Willianlsz1/piezometro-teste/(commit log)

2026-03-28 feat: melhorias completas para defesa do TCC
2026-07-09 Revisão do projeto: firmware versionado, limiares unificados e correções de segurança
    - Adiciona firmware/sketch.ino: código Wokwi com envio ao InfluxDB via WiFi
    (line protocol, a cada 10s), buzzer não bloqueante, loop com millis() e
    notas sobre a limitação do BMP180 como stand-in do transdutor piezométrico
    - Adiciona firmware/diagram.json: circuito Wokwi completo (ESP32 + BMP180 +
    OLED SSD1306 + 3 LEDs + buzzer)
    - Unifica limiares de alerta em 1010/1005 hPa (firmware, dashboard e README),
    compatíveis com o padrão do BMP180 no Wokwi (1013,25 hPa)
    - Dashboard: banner inequívoco de modo simulação + eventos marcados
    '(simulação)'; mín/máx/variação calculados sobre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
    [sketch.ino]
2026-07-09 Reformula projeto para a demanda SAGA: nível d'água, alertas Telegram/SMS e ingestão via servidor
    Alinhamento com o desafio 'Monitoramento Online do Nível de Água em
    Piezômetros' (Samarco / SENAI Mariana):
    - Telemetria passa a ser nível d'água (m): firmware converte a pressão do
    BMP180 (stand-in) em nível simulado (10 hPa = 1 m) e a lógica de alerta
    vira a correta de piezômetro — nível ALTO = perigo (12 m atenção, 15 m
    crítico), espelhada em firmware, dashboard e servidor
    - Alertas preventivos ativos: server.js vigia o InfluxDB e notifica por
    Telegram (gratuito) e/ou SMS via Twilio nas transições de faixa, com
    anti-spam e reenvio do crítico a cada 15 min; hist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
    [sketch.ino]
2026-07-09 Adiciona mapeamento demanda SAGA × projeto × mercado real
    Documento de pesquisa que decompõe a demanda em 8 requisitos e cruza cada
    um com a prática de mercado (Geokon/corda vibrante, Worldsensing/LoRa,
    CMI da Samarco em Germano), a regulação (Res. ANM 95/2022, Lei 14.066/2020,
    níveis de emergência do PAEBM, SIGBM) e projetos acadêmicos similares —
    com fontes citadas e roadmap priorizado de melhorias de autenticidade
    (múltiplos piezômetros, carta de risco, transdutor 4-20mA + ADS1115,
    solar + deep sleep, LoRa no hardware real).
    Claude-Session: https://claude.ai/code/session_018LetC9Cjgkx1fkLP5TURfU
2026-07-09 Adiciona pacote do protótipo físico com sensor JSN-SR04T
    - firmware/sketch_fisico_jsn_sr04t.ino: versão para hardware real que mede
    nível de água de verdade com ultrassônico JSN-SR04T (mediana de 5 leituras,
    zona morta tratada, mantém último nível válido em falha de eco), com a
    mesma pilha do firmware de simulação: WiFi, NTP, store & forward e envio
    JSON ao /ingest com DEVICE_KEY — mesmos limiares 12/15 m via escala de
    maquete (1 cm no tubo = 0,5 m)
    - docs/PROTOTIPO_FISICO.md: lista de compras (~R$ 150-220) com links,
    esquema de ligação pino a pino (divisor de tensão 1k/2k no ECHO),
    montagem do tubo, calibração, roteiro de demonstração de 3 min para a
    ban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
2026-07-09 Adiciona arquitetura alternativa sem servidor (placa e dashboard direto no InfluxDB)
    - firmware/sketch_sem_servidor.ino: variante Wokwi em que o ESP32 grava
    direto no InfluxDB Cloud (line protocol, store & forward com timestamps
    NTP) e dispara os alertas do Telegram direto do firmware, com o mesmo
    anti-spam do servidor (transições de faixa + reenvio do crítico a cada
    15 min); URL do cluster e org já pré-preenchidos, trade-offs documentados
    - index.html: novo bloco INFLUX_DIRECT — preenchendo um token somente
    leitura, o dashboard consulta o InfluxDB Cloud direto do navegador e
    dispensa o Render; barra de status indica o modo ativo (direto/via
    servidor)
    - readme.md: seçã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
2026-07-10 Servidor monitora múltiplos piezômetros e corrige referências quebradas
    - /ingest aceita o campo 'piezometro' (validado) e grava como tag do line
    protocol; leituras sem id continuam funcionando (compatibilidade)
    - Motor de alertas por instrumento: consulta agrupada por tag (parser CSV
    suporta múltiplas tabelas de grupo), estado de notificação por id e
    mensagens do Telegram/SMS identificando qual piezômetro disparou
    - GET /alerts expõe o último estado conhecido de cada piezômetro
    - Corrige referências sem definição no handler HTTP herdadas do merge
    feat/tcc-melhorias-completas (checkRateLimit/log/metrics/url/ip), que
    derrubavam o servidor em qualquer requisição; rate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
2026-07-10 Dashboard multi-piezômetro: visão geral, mapa, períodos, CSV, leituras e guia do operador
    - Visão geral com cartão clicável por piezômetro (PZ-01/02/03) e painel de
    localização com mapa Leaflet/OpenStreetMap (pinos coloridos pelo status,
    fallback gracioso sem CDN); dados agrupados pela tag 'piezometro'
    - Seletor de período 24h/7d/30d nos históricos, com estatísticas e rótulos
    dinâmicos por janela
    - Exportação CSV compatível com Excel pt-BR (BOM, ';', vírgula decimal)
    do piezômetro e período selecionados
    - Painel 'Últimas leituras' (hora, nível, status) e eventos identificados
    por instrumento
    - Faixa recolhível 'Como ler este painel' e descrições curtas nos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
2026-07-10 Migra consultas de Flux para InfluxQL (compatível com InfluxDB Cloud Serverless)
    Contas novas do InfluxDB Cloud são Serverless e não respondem ao endpoint
    Flux (/api/v2/query) — as consultas voltavam vazias mesmo com dados no
    bucket (a escrita v2 funciona). Migração da camada de leitura para o
    endpoint v1 (/query) com InfluxQL, compatível com contas TSM e Serverless:
    - index.html: influxQL() consulta o v1 /query (modo direto com token de
    leitura, ou via novo proxy /queryql); fetchLatest/fetchHistory reescritos
    em InfluxQL com parsing JSON (parseCSV removido); contratos de retorno
    preservados (gráficos, CSV, tabela e visão geral intactos)
    - server.js: motor de alertas consult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
2026-07-10 Remove arquitetura antiga (Render + InfluxDB direto) substituida pelo Cloudflare Worker
    - server.js, test.js, package.json, .env.example: o backend agora e o
    Worker em cloudflare-worker/ (D1 + KV), sem servidor Node no Render
    - firmware/sketch_sem_servidor.ino: a variante que escrevia direto no
    InfluxDB deixa de existir junto com o InfluxDB
2026-07-10 Migra backend para Cloudflare Worker + D1 (v2 da arquitetura)
    - cloudflare-worker/: Worker com /ingest, /ultimos, /dados, /alerts e
    /health; leituras no D1 (SQLite), motor de alertas Telegram/SMS via
    cron trigger de 1 min com estado no KV (gravacao condicional)
    - index.html: dashboard consome /ultimos e /dados (JSON) em vez de
    InfluxQL via proxy; removidos PROXY_URL e INFLUX_DIRECT
    - firmware: comentarios e SERVER_URL de exemplo apontam para o Worker
    - readme.md: reescrito para a nova arquitetura, com secao de historico
    registrando a v1 (Render + InfluxDB)
    - sketch.ino da raiz removido (versao antiga que escrevia direto no
    InfluxDB com token embutido)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
2026-07-10 Adiciona base de conhecimento: piezometros, barragens e mercados de aplicacao
    Documento-fonte consolidado a partir de pesquisa (fontes citadas por secao):
    fisica da poropressao (Terzaghi), tipos de piezometro, instalacao/leitura,
    niveis de controle, desastres de Fundao e Brumadinho, legislacao (PNSB,
    Lei 14.066, ANM 95/2022 e 220/2025), numeros do setor e mercados adjacentes
    com ranking para o pitch. Base para o TCC, slides e video pitch.
2026-07-10 Corrige agregacao por bucket no /dados e configura deploy real
    - CAST(ts / bucket AS INTEGER): o D1 fazia divisao em ponto flutuante,
    o que anulava o agrupamento por bucket (verificado em producao)
    - wrangler.toml: database_id real do D1
    - index.html: API_URL apontando para o Worker publicado
2026-07-10 Adiciona CLAUDE.md com contexto do projeto e modelo de trabalho 10-80-10
2026-07-10 Refatoracao de arquitetura: seams profundos nas tres camadas
    Candidato 1 - Fonte de Leituras (index.html): interface unica
    {simulada, ultimos(), historico()} com dois adapters (FonteApi e
    FonteSimulada). Elimina a simulacao duplicada/desalinhada (bases 10.2
    vs 10), o setInterval paralelo do simTick e o vazamento do flag
    simActive; troca real<->simulacao concentrada em trocarFonte().
    Candidato 2 - Nucleo comum do firmware: piezometro_core.h (411 l.)
    com WiFi/NTP/buffer/envio/alertas/LEDs/buzzer/OLED; sketches viram
    adapters de sensor (555->141 e 652->224 linhas). struct Leitura no
    core (e a interface, nao detalhe do sketch). Sensor da Fase 2 entra
    como 3o adapter.
    Candidato 3 - GET /config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
    [piezometro_core.h, sketch.ino, sketch_fisico_jsn_sr04t.ino]
2026-07-10 Adiciona pesquisa sobre dashboards profissionais e plano de melhorias
    Plataformas comerciais (MonitorIQ, GeoMoS, Worldsensing, VDV), tratamento
    de perda de sinal (Good/Uncertain/Bad, stale data), estados de instrumento,
    leituras derivadas (taxa de variacao, % projeto), normas ISA-101/ISA-18.2/
    EEMUA 191 e anti-padroes - com plano priorizado P1-P8 para o dashboard.
2026-07-10 P1+P2+P3: estado SEM SINAL, alarme de comunicacao e taxa de variacao
    P1 (dashboard): instrumento sem reportar alem de STALE_SEG vira estado
    SEM SINAL (cinza hachurado, cor+texto, "ultima leitura ha X min");
    alarme de nivel suspenso com dado stale (ausente nunca conta como
    normal); gap visivel no grafico sem interpolar; leitura velha nao e
    re-registrada como nova; marcador cinza no mapa.
    P2 (worker): camada de alarme de comunicacao separada da de nivel -
    silencio > SILENCE_ALERT_SEC notifica Telegram/SMS na transicao (e na
    recuperacao), estado commStatus no KV; alertLog ganha campo tipo
    (nivel/comunicacao/taxa). Verificado em producao (PZ-01 SEM_SINAL).
    P3 (worker+dashboard): taxa de variac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
2026-07-10 P4+P5+P6: alarmes vs eventos, pico junto da media e sobriedade ISA-101
    P4: painel dividido em ALARMES (exigem acao - com a acao esperada por
    linha) e EVENTOS (informativos), listas separadas com contadores;
    histerese assimetrica (subida imediata, descida exige folga de
    HISTERESE_M=0.2 abaixo do limiar) no worker (classifyComHisterese no
    motor) e no dashboard (badge e deteccao de borda) - elimina alarme
    chattering na borda do limiar (ISA-18.2 deadband).
    P5: /dados agrega MAX(nivel_agua) por bucket alem da media; grafico
    de nivel desenha a serie do pico como linha tracejada com legenda;
    stat MAX 24H usa o pico; CSV ganha coluna nivel_max. Validado com
    dados reais: bucket com media 13,84 m (AT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
2026-07-10 Adiciona plano de refatoracao anti-godfile (dashboard e worker em modulos)
2026-07-10 Refatora worker em 7 modulos ES (config, http, db, alertas, notificacoes, rotas, index)
    Zero mudanca de comportamento - validado em producao com a bateria completa de endpoints. index.js virou so o roteador (~76 l.); db.js e dono de todas as queries D1 (query de /ultimos unificada com a da camada de comunicacao na revisao).
2026-07-10 Refatora dashboard: index.html (277 l.) + styles.css + 8 modulos JS
    Zero mudanca de comportamento - CSS em assets/styles.css e o script em assets/js/{config,util,fontes,estado,graficos,paineis,exportar,app}.js carregados em ordem de dependencia (escopo global, sem bundler - compativel com GitHub Pages). Validado no navegador: render identico, console limpo.
2026-07-10 Atualiza guia da maquete para a arquitetura v2 e adiciona roteiro de defesa
    PROTOTIPO_FISICO.md: referencias Render/InfluxDB trocadas por Cloudflare Worker (SERVER_URL, DEVICE_KEY via wrangler secret). DEFESA_BANCA.md: posicionamento frente a equipamentos profissionais, com perguntas provaveis e respostas.
2026-07-13 Corrige falso 'sem sinal' no dashboard com Wokwi em simulacao
    Frescor/comunicacao passam a usar a hora de RECEBIMENTO no Worker
    (nova coluna recebido_em) em vez do ts do device, que deriva no
    relogio simulado do Wokwi. Firmware re-sincroniza NTP a cada 5 min
    e STALE_SEG sobe de 60 para 120s (simulacao roda mais lenta que o
    tempo real). Migracao: migrations/0001_recebido_em.sql (aplicar
    antes do wrangler deploy).
    Claude-Session: https://claude.ai/code/session_01RKkR7Ama1X95U16pZjmgTV
    [piezometro_core.h]
2026-07-13 Adiciona deploy automatico do Worker via GitHub Actions
    Workflow que aplica a migracao do D1 (idempotente) e publica o Worker
    a cada push na main que toque cloudflare-worker/, ou manualmente pela
    aba Actions. Pensado para operar o projeto so pelo navegador, sem
    terminal. Requer o secret CLOUDFLARE_API_TOKEN no repositorio.
    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
2026-07-13 Integridade do monitoramento + docs de validacao e defesa da banca
    Worker: /ingest falha fechado sem DEVICE_KEY; indice unico
    (piezometro, ts) + INSERT OR IGNORE torna o reenvio do buffer
    idempotente (migracao 0002); ts ausente reconstruido pela posicao
    no lote; piezometro invalido e rejeitado em vez de virar PZ-01.
    Firmware: falha de OLED/BMP180 degrada em vez de travar (while(1)
    removido); wifiOk atualizado a cada despacho; leitura sem eco nao
    e enviada como medicao nova (campo valida no struct Leitura).
    Dashboard: token de requisicao elimina race na troca de pz/periodo;
    poll imediato ao voltar de aba em background; CSV exporta o periodo
    completo (histPontos), nao a janela de 60 pontos do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
2026-07-13 Workflow de deploy aplica tambem a migracao 0002 (dedupe + indice unico)
    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
2026-07-13 Adiciona rascunho do TCC estruturado no template oficial do SENAI
    docs/TCC_RASCUNHO.md espelha as secoes do TEMPLATE_INTEGRA_MG.docx
    (Problema, Solucao, Justificativa, Objetivos, Desenvolvimento,
    Viabilidades, Resultados, Anexos/BMG Canvas), preenchido com o
    conteudo ja documentado do projeto e marcadores [PREENCHER] onde
    dependem da equipe (nomes, resultados do ensaio de validacao,
    situacao de aprendizagem).
    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
2026-07-13 Adiciona viabilidade economica detalhada e comparativo de mercado pesquisado
    VIABILIDADE_ECONOMICA.md: BOM nos cenarios prototipo (R$150-220) e
    campo real (R$586-1.179), OPEX, tres metodos de precificacao
    convergindo em R$1.000-3.500/ponto + assinatura R$30-80/mes,
    paybacks do cliente (<46 dias), TAM/SAM/SOM com premissas editaveis
    e a separacao demanda SAGA vs mercado comercial real.
    COMPARATIVO_MERCADO.md: pesquisa web (17 buscas, 13/07/2026) — 8
    fabricantes de telemetria geotecnica sem preco publico, unica
    referencia dura US$1.636-2.370/instrumento (IBRACON 2007),
    plataformas IoT genericas e projetos academicos proximos, com
    fontes e avisos do que nao pode ser verificado.
    Co-Authored-B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
2026-07-13 Adiciona cenario hipotetico da reducao dos R$600 mil/ano (secao 4.3)
    Decompoe o numero do edital em contrato terceirizado plausivel
    (R$50 mil/mes, ~100 pz lidos 2x/semana ≈ R$58/leitura), mostra
    item a item o que o sistema elimina e o que permanece, e calcula a
    reducao: custo recorrente cai de R$600 mil para R$50-62 mil/ano
    (~90%), payback da implantacao em 2-4 meses.
    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
2026-07-13 CSV de auditoria no export + doc da cadeia de confianca
    Export CSV: bloco de metadados (instrumento, periodo, intervalo de
    agregacao, gerado em, fonte real/simulada, limiares, total de
    intervalos), colunas de minimo e nº de leituras por intervalo,
    status calculado pelo PICO (P5 — pico de 17 m nao sai mais como
    Normal pela media) e coluna de qualidade (nivel zero suspeito,
    poucas leituras). Worker /dados devolve nivel_min, n_leituras e
    bucket_seg; historico() passa a devolver { pontos, bucket_seg }
    nos dois adapters.
    Novo docs/CADEIA_DE_CONFIANCA.md: integridade vs validade
    metrologica, tabela elo→protecao→codigo, quem garante no mundo
    real (RBC/projetista/ANM) e lacunas admitidas.
    Co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
2026-07-13 Exportar Excel formatado no modelo de relatorio (SpreadsheetML)
    Novo botao 'Exportar Excel' gera planilha .xls sem biblioteca
    externa: titulo mesclado, linhas de contexto/auditoria, cabecalho
    colorido, celula de Status na cor da faixa (pelo pico) e secao
    RESUMO DO PERIODO (min/max/media e contagem de intervalos em
    atencao/critico) — organizacao espelhada na planilha-modelo do
    usuario. CSV mantido como dados brutos; ambos partem das mesmas
    linhas via coletarLinhasExportacao() (regra unica, P5).
    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
2026-07-13 Adiciona doc de alimentacao de energia (hoje, mercado, dimensionamento)
    Consumo atual ~30 Wh/dia (WiFi sempre ligado); o que o mercado usa
    (baterias de litio de anos nos nos wireless; 12V+solar nas
    estacoes); tres opcoes dimensionadas com conta aberta: powerbank
    (2 dias), solar 20W + bateria 18Ah (3,6 dias sem sol, sem mudar
    codigo) e deep sleep (~30x menos consumo, trade-offs honestos);
    recomendacao em camadas e resposta pronta para a banca (lacuna
    ANM 95/2022).
    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
2026-07-14 Implementa modo deep sleep opcional para campo a bateria/solar
    Novo firmware/piezometro_deep_sleep.h (opt-in via MODO_DEEP_SLEEP):
    ciclo acorda-mede-envia-dorme de 5 min com buffer de store &
    forward em memoria RTC (96 leituras, ~2,3 KB — sobrevive ao sono),
    payload byte-compativel com o do core, re-sync de NTP pela
    validade do relogio (que persiste no RTC) ou a cada ~1 h, e tela
    rapida de depuracao no OLED. Modo padrao dos sketches permanece
    sempre-ligado (demonstracao da maquete). Docs de energia e
    CLAUDE.md atualizados.
    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
2026-07-14 Reescreve o rascunho do TCC em prosa profissional (primeira entrega)
    Texto corrido humanizado, sem travessoes nem listas de hifen,
    incorporando todo o material produzido: cadeia de confianca do
    dado, exportacao de relatorios, modo deep sleep, energia
    dimensionada, comparativo de mercado com fontes, cenario dos
    R$600 mil, precificacao por tres metodos e TAM/SAM/SOM. Tabelas
    apenas onde o template exige (equipe e BMG Canvas); 8 marcadores
    [PREENCHER] consolidados ao final.
    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
2026-07-14 Gera TCC_ENTREGA.docx nas normas ABNT para envio ao professor
    Documento Word real gerado do rascunho: capa, folha de rosto e
    sumario; A4 com margens 3/3/2/2 cm; Arial 12 justificado,
    espacamento 1,5 e recuo de 1,25 cm; titulos na numeracao do
    template SENAI; tabelas de equipe e BMG Canvas; marcadores
    [PREENCHER] em vermelho/negrito para nao passarem despercebidos.
    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
2026-07-14 TCC autocontido: remove referencias a arquivos do repositorio e cita automacao
    O texto nao manda mais o leitor 'ver docs/*.md' — o conteudo
    referenciado (componentes, protocolo de validacao, demonstracao de
    resiliencia, base do BMG Canvas) foi escrito no proprio TCC. A
    Situacao de Aprendizagem passa a citar automacao de processos
    entre as competencias. TCC_ENTREGA.docx regenerado e validado.
    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
2026-07-14 Viabilidade economica assertiva: numeros fechados, payback e ROI
    Secao 1.3.6 reescrita com convicção: produto custa R$220
    (prototipo), R$900 (campo) e R$1.400 instalado; empresa gasta
    R$600 mil/ano e passa a gastar R$57 mil/ano; economia de R$543
    mil/ano (91%), payback de 3,1 meses, ROI de 288% no primeiro ano
    e >1.800% em cinco anos; preco de R$2.500/ponto + R$50/mes com
    payback do cliente em ~6 meses. Removidos TAM/SAM/SOM, faixas
    repetidas e a cifra de centenas de milhoes; mercado em duas
    frases concretas (1% = 900 pontos = R$540 mil/ano recorrentes).
    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
2026-07-14 Profissionalizacao: chave por dispositivo, retencao de dados e blueprint
    Worker: DEVICE_KEYS (JSON pz→chave) permite revogacao individual
    sem afetar a frota, com fail-closed mantido e checagem fina de
    qual pz cada chave autoriza; retencao automatica consolida
    leituras brutas com mais de 180 dias em 1 linha/dia/pz
    (leituras_diario, migracao 0003) e roda 1x/dia pelo cron com
    guarda no KV — erro na retencao nao derruba o salvamento do
    estado dos alertas (try/catch adicionado na revisao).
    Novo docs/PROJETO_PROFISSIONAL.md: especificacao da versao de
    producao construida sobre a plataforma existente (sensor via
    adapter, energia deep sleep+solar, LoRaWAN, seguranca, dados,
    operacao, conformidad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
2026-07-14 TCC posiciona o prototipo como representacao e o trabalho como o conjunto
    Tres insercoes: em Solucao, o papel de cada parte (prototipo =
    representacao funcional; produto do trabalho = plataforma +
    especificacao profissional + pesquisa + economia + validacao);
    em Desenvolvimento, a versao de producao (adapter, deep sleep,
    LoRaWAN, chave por dispositivo e retencao ja implementadas,
    roadmap com custos); em Resultados, o conjunto de engenharia que
    existe independentemente do prototipo. Docx regenerado.
    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
2026-07-14 Separa docs em projeto/ (face empresa) e prototipo/ (maquete/banca)
    - docs/projeto/: base de conhecimento, mercado, padroes ISA e a nova
    especificacao industrial PROJETO_INDUSTRIAL.md (AquaSense/UCT), com
    secao 10 consolidando as divergencias abertas com o rascunho do TCC
    (shunt 250 vs 150 ohms, MQTT/Grafana vs backend Cloudflare, IP66/67,
    numeros economicos)
    - docs/prototipo/: guia da maquete fisica, defesa na banca e plano de
    refatoracao executado
    - Corrige todos os links para os novos caminhos (readme, CLAUDE.md,
    wrangler.toml, firmware e comentarios do codigo)
    [sketch_fisico_jsn_sr04t.ino]
2026-07-14 Reescreve viabilidade economica para o sistema industrial (UCT AquaSense)
    BOM com precos reais pesquisados (16 buscas, fontes e datas),
    fechamento exato dos R$260 mil em 50 pontos (hardware 148.250 +
    instalacao 40.000 + sobressalentes 14.825 + bancada 25.000 +
    contingencia 31.925), OPEX anual real de R$39.155 (chips M2M,
    nuvem, manutencao, inspecoes), payback 5,6 meses, ROI 116% ano 1
    e 978% em 5 anos, com analise de sensibilidade. Prototipo fora do
    escopo (apenas representacao).
    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
2026-07-14 OPEX: registra as duas rotas de reducao do custo dos chips 4G
    Plano IoT sob medida (R$5-10/mes, item cai a R$6 mil/ano) e
    gateway LoRaWAN compartilhado (1 chip de backhaul, R$240/ano).
    R$12 mil/ano mantido na conta principal como pior caso com fonte.
    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
2026-07-14 Fecha as 7 divergencias TCC x repositorio e alinha IP66 (pendencia 2)
    Secao 10 do PROJETO_INDUSTRIAL vira registro de decisoes fechadas:
    shunt 150 ohms, backend real Cloudflare, IP66 nos dois textos
    (RNF2/diagramas/BOM alinhados de IP67 para IP66), Telegram/SMS,
    par economico oficial (R$260 mil / payback 5,6 meses / -93,5%),
    cadencia de demonstracao explicitada e WiFi só no prototipo.
    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
2026-07-14 Pendencia 3: TCC oficial AquaSense no repositorio; rascunho vira historico
    TCC_AQUASENSE.md transcreve fielmente o TCC da equipe (PDF) com as
    correcoes fechadas: titulo sem placeholder, composicao oficial dos
    R$260 mil, OPEX/reducao de 93,5%/payback/ROI na viabilidade,
    grafia piezorresistivo/ESP32, BOM com custo de referencia e
    marcadores [PREENCHER] nos anexos pendentes. TCC_ENTREGA.docx
    regenerado (ABNT) a partir dele. TCC_RASCUNHO.md recebe nota de
    documento historico/material-fonte.
    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
2026-07-14 Pendencia 4: protocolo de homologacao da UCT na bancada de 2 m
    Fisica do ensaio com contas abertas (3,2 mA/m; 4,0-10,4 mA e
    0,6-1,56 V na bancada; resolucao do ADS1115), cinco etapas (loop
    eletrico, calibracao de dois pontos, curva de exatidao 5x10,
    resistencia de 72 h com cortes provocados de rede e energia,
    ensaio de energia) e criterios go/no-go (exatidao +-3 cm,
    repetibilidade 2 sigma <= 2 cm, zero perda/duplicata, deriva RTC
    < 2 s/dia) com tabelas prontas e frase de aceite final.
    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
2026-07-14 Pendencia 5: adapter da UCT industrial (transdutor 4-20 mA + ADS1115)
    Novo sketch_uct_4a20ma.ino pelo contrato de adapter do core:
    ADS1115 com GAIN_ONE (0,6-3,0 V do shunt de 150 ohms), media de 16
    amostras, calibracao de dois pontos como defines (coeficientes da
    etapa E2 da homologacao), deteccao de falha NAMUR NE43 (<3,6 mA
    loop rompido, >21 mA curto — leitura invalida nao entra no
    historico), modo degradado sem while(1), display com corrente e
    tensao do loop, compatibilidade com sempre-ligado e deep sleep, e
    roteiro de teste de bancada no rodape. CLAUDE.md e
    PROJETO_INDUSTRIAL.md anotados.
    Claude-Session: https://claude.ai/code/ses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
2026-07-14 Pendencia 6: fonte/powerbank opcional na lista de compras da maquete
    Item opcional recomendado (R$30-80): independencia do notebook na
    apresentacao e demonstracao ao vivo da opcao A do estudo de
    energia. Total obrigatorio de R$150-220 preservado (numero citado
    no TCC), com anotacao do adicional.
    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
2026-07-14 Reescreve a viabilidade economica do TCC em linguagem acessivel
    Secao 1.3.6 reestruturada apos pesquisa de metodologia (SEBRAE/
    EVTE): cada custo com a historia de como foi levantado (pesquisa
    de precos em lojas nacionais com exemplos, hora tecnica, piso de
    R$1.804 vs referencia R$2.965 explicada), reconstrucao dos
    R$600 mil contada passo a passo (R$50 mil/mes -> R$58/leitura),
    payback e ROI traduzidos em palavras (cada R$1 vira R$2,16 no
    ano 1 e quase R$11 em 5 anos), pesquisa de mercado narrada e
    jargao eliminado. Numeros oficiais preservados. Docx regenerado.
    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
2026-07-14 Adiciona secao REFERENCIAS ao TCC (47 fontes em formato ABNT)
    Compila todas as fontes que sustentam o documento: legislacao
    (PNSB, Lei 14.066, Resolucao ANM 95/2022), dados oficiais ANA/
    SNISB, normas tecnicas (ISA-18.2, NAMUR NE43), os oito fabricantes
    da pesquisa de mercado, o artigo IBRACON 2007, as lojas da
    pesquisa de precos com data de acesso e o edital SAGA. Ordem
    alfabetica, NBR 6023; referencias renderizadas no docx sem recuo
    e com espacamento simples (padrao ABNT). Sumario atualizado.
    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
2026-07-14 Graficos na viabilidade economica e tabelas no padrao ABNT aberto
    Tres graficos gerados em Python (paleta azul/laranja validada por
    contraste e daltonismo, imprime bem em P&B): composicao do
    investimento (barras horizontais), custo anual manual x AquaSense
    (reducao de 93,5% visivel) e saldo acumulado com ponto de
    equilibrio em 5,6 meses. Embutidos no docx com legenda ABNT acima
    e fonte abaixo; PNGs versionados em docs/tcc/graficos. Todas as
    tabelas convertidas de grade completa para tabela aberta ABNT
    (linhas horizontais no topo, cabecalho e base).
    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
2026-07-15 Demo fisica HC-SR04 no repo + diario de bordo do bring-up
    - firmware/sketch_demo_hc_sr04.ino: adapter da demo de bancada sem agua
    (mao = agua; 10 cm = critico), credenciais sanitizadas, compilado e
    gravado com sucesso no ESP32 fisico (82% da flash)
    - docs/prototipo/BRINGUP_FISICO.md: estado real da montagem (driver
    CP210x resolvido, upload via botao BOOT, store & forward confirmado)
    e pendencias com diagnostico (sensor sem eco: 4 causas; OLED; WiFi)
    - readme: arvore atualizada com firmware e docs que faltavam
2026-07-15 Alinha o TCC ao escopo real e gera a entrega no template INTEGRA
    Escopo (o texto declarava como feito trabalho fisico inexistente):
    - Fase III dizia que a equipe conectou o transdutor a bancada e calibrou
    o shunt de 150 ohms por dois pontos; isso nao aconteceu e contradizia
    a propria secao de Resultados. Reescrita para o que houve: o
    desenvolvimento do backend e a definicao do metodo de calibracao.
    - Fase II dizia que Marcelo montou o circuito fotovoltaico e Matheus
    montou a tubulacao de PVC; ambos sao projeto/dimensionamento da
    unidade industrial, nao montagem. Corrigido.
    - Fase IV e Resultados passam a registrar o que existe de fato: o
    prototipo funcional de bancada (microcontr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
2026-07-15 Protege o gerador contra a marcacao de titulo removida por engano
    Ao preencher o codigo da unidade e facil apagar tambem o "# " inicial,
    que e a marcacao de titulo do markdown e nao parte do placeholder. Sem
    ela o parser nao encontrava nenhum heading de nivel 1 e o script morria
    com IndexError, sem dizer o motivo.
    Agora o gerador valida a primeira linha e, se ela nao comecar com "# ",
    explica o formato esperado. O titulo passa a ser o primeiro heading de
    nivel 1 (em vez de ser procurado pelo texto do placeholder), e o script
    avisa quando o codigo da unidade ainda nao foi preenchido ou nao esta
    entre cerquilhas como o manual exige.
    Preenchido: instrutor orientador (Jairo).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
2026-07-15 Corrige o titulo da capa, que nunca era substituido, e fecha os campos
    Bug: a capa saia com o texto "TÍTULO DO PROJETO" do template em vez do
    titulo do trabalho. O Word quebra o texto em varios <w:r>/<w:t>
    ("TÍTULO DO " + "PROJETO"), entao procurar o marcador run a run nunca
    casava e a substituicao falhava em silencio. A checagem anterior nao
    pegou porque olhava só d.paragraphs, que nao enxerga o conteudo dos
    controles de conteudo (SDT) onde a capa vive.
    Agora preencher_capa() compara o texto por paragrafo, escreve o titulo
    no primeiro run e esvazia os demais, preservando a formatacao. O script
    aborta se o marcador nao for encontrado, em vez de gerar capa furada.
    Campos, conforme decisa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
2026-07-15 Reescreve Como levantamos os custos com foco no metodo
    Sai a ressalva sobre a equipe nao ter formacao em financas: ela nao
    responde a pergunta do orientador (como os custos foram levantados) e
    enfraquece um levantamento que se sustenta sozinho.
    O texto passa a abrir pelo que de fato da credibilidade ao numero: cada
    preco tem loja e data registradas (julho de 2026) e fonte relacionada
    nas referencias, entao qualquer valor pode ser reconferido no anuncio
    original. Os precos saem do paragrafo corrido para uma sequencia legivel
    e o total de R$ 1.804 fica isolado no fechamento, junto da ressalva de
    que e piso de referencia, nao custo final.
    Numeros, fontes e conclusao inalterados.
    Co-Authored-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
2026-07-15 Separa a meta do edital do gasto estimado pela equipe
    O texto dizia que "o edital declara uma economia potencial de R$ 600 mil
    por ano" e, dali em diante, usava esse valor como se fosse o gasto atual
    informado pela empresa ("comparando o gasto atual de R$ 600.000,00...").
    Nao e o caso. O edital lista a economia de R$ 600.000/ano entre os
    beneficios esperados de qualquer solucao proposta: e a meta de retorno
    fixada pela empresa, nao uma informacao sobre o quanto ela gasta hoje. O
    custo atual da medicao manual nao e divulgado e a equipe nao teve acesso
    a ele; os R$ 600 mil usados nas contas sao uma estimativa deduzida de
    referencias de mercado (contrato terceirizado de ~R$ 50 mil/mes, ~R$ 58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
2026-07-15 Corrige o instrumento da leitura manual: pio eletrico, nao trena
    O texto dizia que a leitura e feita "com trenas eletricas ou sonoras". O
    instrumento correto e o pio eletrico: sonda em fita graduada que desce no
    tubo e emite sinal sonoro ao tocar a agua, fechando o circuito. Nao sao
    dois instrumentos (eletrico "ou" sonoro): e um so, que e as duas coisas.
    "Trena" remete a fita metrica de construcao e qualquer avaliador da area
    nota.
    Aproveita para nomear o tipo de piezometro que o projeto automatiza
    (Casagrande, de tubo aberto), o que reforca a proposta: o transdutor
    submersivel desce no mesmo tubo onde hoje desce o pio eletrico, entao a
    automacao nao troca o instrumento, troca quem le. Piez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
2026-07-17 Corrige 5 achados do review de confiabilidade (2 graves, 3 medios)
    Graves:
    - Motor de alertas de nivel media o frescor pelo relogio do device (ts);
    com RTC atrasado >5 min um nivel CRITICO real nunca notificava. Agora
    usa recebido_em (relogio do servidor), como a camada de comunicacao.
    - Historico simulado do fallback local podia ser exportado em CSV/XLS
    rotulado como API real. Novo flag histSimulado propaga a origem ate
    o rotulo de auditoria do export.
    Medios:
    - Clamp de relogio adiantado colapsava o lote inteiro no mesmo ts e o
    indice unico descartava N-1 leituras em silencio; agora escalona.
    - taxa_m_dia da simulacao era sempre 0.000 (nAnterior capturado depois
    do drift); rec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
2026-07-17 Firmware: display atras do seam Tela e adapters de sensor enxutos
    Prepara o terreno para o prototipo v2 (troca do OLED por TFT e novo
    sensor de pressao MPS20N0040D) sem mudar comportamento observavel.
    Seam Tela:
    - Nova interface Tela (tela.h): iniciar/limpar/escreverLinha por slots/
    destacarStatus por faixa/mostrar/telaInicio/atenuar. O core e os hooks
    de sensor nao conhecem mais Adafruit_SSD1306.
    - Adapter TelaSSD1306 (tela_ssd1306.h): todo o codigo do OLED migrado
    com layout pixel a pixel identico. Um futuro tela_ili9341.h entra sem
    tocar no core nem nos sketches.
    - Hook dos sketches muda de linhasExtrasDisplay(Adafruit_SSD1306&) para
    linhasExtrasDisplay(Tela&).
    - Deep sleep: co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
2026-07-17 Atualiza o README para o estado atual do projeto
    - Nome oficial AquaSense no titulo e contexto SENAI/Samarco na abertura
    - Nova secao "Estado do projeto": producao no ar, prototipo fisico
    validado ponta a ponta (16/07), TCC entregue, v2 em preparacao
    - Firmware: documenta a estrutura nucleo + adapters + interface Tela e
    os dois caminhos de uso (bancada fisica com piezometro_config_local.h
    e simulacao Wokwi com credenciais inline)
    - Dashboard: corrige instrucao de configuracao (API_URL em
    assets/js/config.js, nao mais WORKER_URL no index.html) e nota de que
    os limiares vem do Worker via GET /config
    - Arvore do projeto: inclui tela.h, tela_ssd1306.h, config example,
    retencao.js, mi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
2026-07-17 Pagina Alerta a Populacao: sirene coletiva via QR code no auditorio
    Nova pagina standalone alerta.html (QR code no slide, zero instalacao):
    a plateia abre no celular, toca em ATIVAR, e quando o nivel da maquete
    cruza o limiar CRITICO todos os celulares tocam sirene (WebAudio),
    vibram (Android) e piscam vermelho com mensagem estilo Defesa Civil,
    simulando o alerta a Zona de Autossalvamento (ZAS).
    - Reusa config.js/util.js (limiares reais via GET /config, classificacao
    e frescor identicos ao dashboard); poll de GET /ultimos a cada 5 s
    - Estados: aguardando, normal, atencao (2 beeps), critico (sirene +
    vibracao + wake lock), sem sinal (nunca finge normal), normalizado
    (4 s, apenas na vol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
2026-07-17 Corrige telas empilhadas na pagina de alerta: hidden vencido pelo display:flex do .tela (pego no primeiro teste real; [hidden] agora forca display:none)
2026-07-17 Corrige rotulo ATENCAO/CRITICO sumido do OLED: pisca por paridade de millis com display a 1 Hz ficava preso na fase apagada; status agora sempre visivel (urgencia continua nos LEDs/buzzer)
    [piezometro_core.h]
2026-07-17 Refinamento UX do dashboard: marca AquaSense, tipografia maior, dado ausente honesto (n/d + Sem sensor no lugar de 1013/24 fabricados), rotulos de exportacao explicados (dados brutos CSV vs relatorio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
2026-07-17 P6/ISA-101: sobriedade de cor no dashboard. Estado normal em tons neutros (numero branco, badge cinza, pino do mapa e sparklines dessaturados, linhas de grafico neutras); cor saturada reservada a ate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
2026-07-17 Relatorio imprimivel (PDF): pagina A4 tema claro com resumo executivo, grafico com limiares, tabela por intervalo com status pelo pico e bloco de auditoria; botao no dashboard acompanha pz/periodo se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
2026-07-17 Card de pressao vira Poropressao calculada (u = 9,807 kPa/m sobre o nivel MEDIDO) quando nao ha sensor de pressao: grandeza real de piezometro, rotulada Calculada, dinamica com a agua da maquete; com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
2026-07-18 Oculta card e grafico de temperatura enquanto a grandeza nao for instrumentada; layout reorganiza em 2 cards / 1 grafico e volta sozinho ao normal na 1a leitura com temperatura real (Wokwi/BMP hoje, 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
2026-07-18 Guia Mestre do projeto (502 l., 12 secoes: pitch, problema, piezometro, leis, solucao parte a parte, custos, cadeia de confianca, defesa, diagnostico, glossario) + Pesquisa Externa (17 fontes abertas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
2026-07-18 Corrige 2 docs desatualizados achados na auditoria do Guia Mestre: PREPARACAO_BANCA adota os numeros oficiais (R$ 600 mil/ano manual, economia R$ 560.845, payback 5,6 meses; nota separando custo do p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
2026-07-23 Remove documentacao interna do repositorio publico
    O repositorio vai ser divulgado no LinkedIn (serie de posts do TCC) e a
    documentacao de trabalho nao deve ficar exposta: docs/projeto/,
    docs/prototipo/, docs/tcc/ e o CLAUDE.md saem do versionamento (entram
    no .gitignore e continuam existindo localmente). Em docs/ permanecem
    apenas GUIA_MESTRE.md e PESQUISA_EXTERNA_PIEZOMETROS.md. O readme foi
    ajustado para nao apontar links quebrados para os arquivos removidos.
